H1potenus/Negatif-iyonizer/docs/pcb_baski_maskesi.pdf

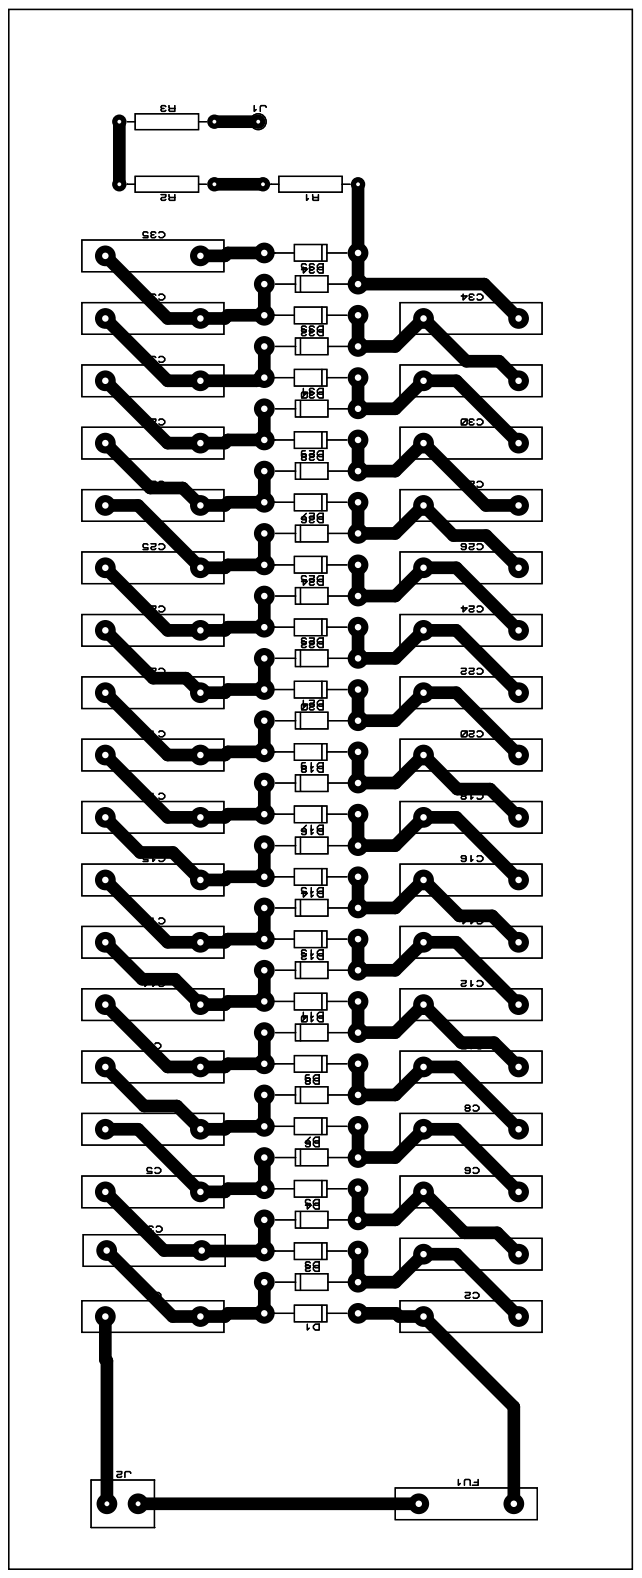
[picture p6: page 1]
