H1potenus/Negatif-iyonizer/(list of files, drawings)

Other design files:
proteus/negatif_iyonizer.pdsprj
proteus/negatif_iyonizer_pcb.pdsprj
